innexgo/PCB/README.md

## PCB

This repository contains various designs that may be used in our products.

### Structure

#### In Development

---

In this folder, there are projects in various states of completion, Assume that projects in this folder use designs that are licensed by others. Usage of these designs is *at your own risk*, both functionally and legally.

#### Releases

---

In this folder, the projects are in a stable state, having been tested to work. Again, usage is *at your own risk* and is subject to the license(s) specified in their respective READMEs.
