innexgo/PCB/In Development/ID-12 Board/README.md

# ID-12LA Board for the ESP32 Devkit
---
PCB files for the RFID controller board in KiCad schematic and board layout.

### Features
- Power LED
- 2 Status LEDs
- 3.3v Buzzer on board 
- Allows for jumpering unused ESP32 pins

# Description
---
For usage with the 30-pin ESP32 Devkit and an ID-12 module connected through UART.

The files in contained herein are designed by Henry Chen/probablyanasian for Innexgo LLC. 

We release this design for use under the [CERN Open Hardware Licence Version 2 - Weakly Reciprocal License](/LICENSE_CERN_OHL_W_2-0.txt).
