innexgo/PCB/In Development/MFRC522 Board/README.md

## MFRC522 board for the NodeMCUv2

PCB files for the RFID controller board - in KiCad schematic and board layout.

## Description

For usage with the NodeMCUv2, connects to the MFRC522 through SPI.

#### Features

- ###### MFRC522 over SPI

- ###### Tuned 13.56MHz Antenna (adapted, see [licenses](#licenses))

- ###### Controllable Status light

- ###### 440 Hz buzzer || passive buzzer

## Licenses

The antenna and matching circuitry was designed by Limor Fried/Ladyada and Kevin Townsend for Adafruit Industries.

It has been adapted to be used with the MFRC522 IC from NXP.

Their original design can be found here: [Adafruit NFC/RFID controller breakout board - v1.6 PCB](https://github.com/adafruit/Adafruit-PN532-RFID-NFC-Breakout), under the Creative Commons Attribution-ShareAlike 3.0 Unported license.

Creative Commons Attribution-ShareAlike 3.0 Unported legal text: [Web Link](https://creativecommons.org/licenses/by-sa/3.0/legalcode)  |  [Current Repo Link](/LICENSE_CC_BY_SA_3.txt)

Original README.md text from their repo: [Web Link](https://github.com/adafruit/Adafruit-PN532-RFID-NFC-Breakout/blob/master/README.md)  |  [Current Repo Link, assetless](ref/Adafruit_PN532_Breakout_README.md)

---

Additional work designed by Henry Chen/Probably an Asian for Innexgo LLC.

All additional work by Henry Chen/Probably an Asian is licensed under the Creative Commons Attribution-ShareAlike 4.0 International License. To view a copy of this license, visit [Web Link](http://creativecommons.org/licenses/by-sa/4.0/),  [Current Repo Link](/LICENSE_CC_BY_SA_4.txt), or send a letter to Creative Commons, PO Box 1866, Mountain View, CA 94042, USA.
