innexgo/PCB/In Development/LED Board/README.md

## LED Panel

PCB files for a LED light - in KiCad schematic and board layout.

## Description

#### Features

- ###### ~20mA current controlled

- ###### Current is controllable using trimmer potentiometer

- ###### Designed for 0.5W components

- ###### Designed with a screw terminal in mind

## Licenses

Designed by Henry Chen/Probably an Asian.

Work is licensed under the Creative Commons Attribution-ShareAlike 4.0 International License. To view a copy of this license, visit [Web Link](http://creativecommons.org/licenses/by-sa/4.0/),  [Current Repo Link](/LICENSE_CC_BY_SA_4.txt), or send a letter to Creative Commons, PO Box 1866, Mountain View, CA 94042, USA.
