innexgo/PCB/Releases/LED Timer/README.md

## LED Timer board for the ESP-12 controllers

PCB files for the LED Timer Board - in KiCad schematic and board layout.

## Description

For usage with an ESP-12 Module, connects to 12V LED tape.

#### Features

- ###### Indicator Lights (12V, 3.3V, Status) 3.3v also indicates a healthy 5V supply.

- ###### Controllable status light

- ###### Multifunctional switch

- ###### Reset switch

- ###### External power port

## Licenses

---

Designed by Henry Chen/Probably an Asian for Innexgo LLC.

All work by Henry Chen/Probably an Asian is licensed under the Creative Commons Attribution-ShareAlike 4.0 International License. To view a copy of this license, visit [Web Link](http://creativecommons.org/licenses/by-sa/4.0/),  [Current Repo Link](/LICENSE_CC_BY_SA_4.txt), or send a letter to Creative Commons, PO Box 1866, Mountain View, CA 94042, USA.
