innexgo/PCB/In Development/LED Timer/LED Timer/LED Timer.kicad_pcb

## KiCad design In Development/LED Timer/LED Timer/LED Timer.kicad_pcb (2021-04-25)

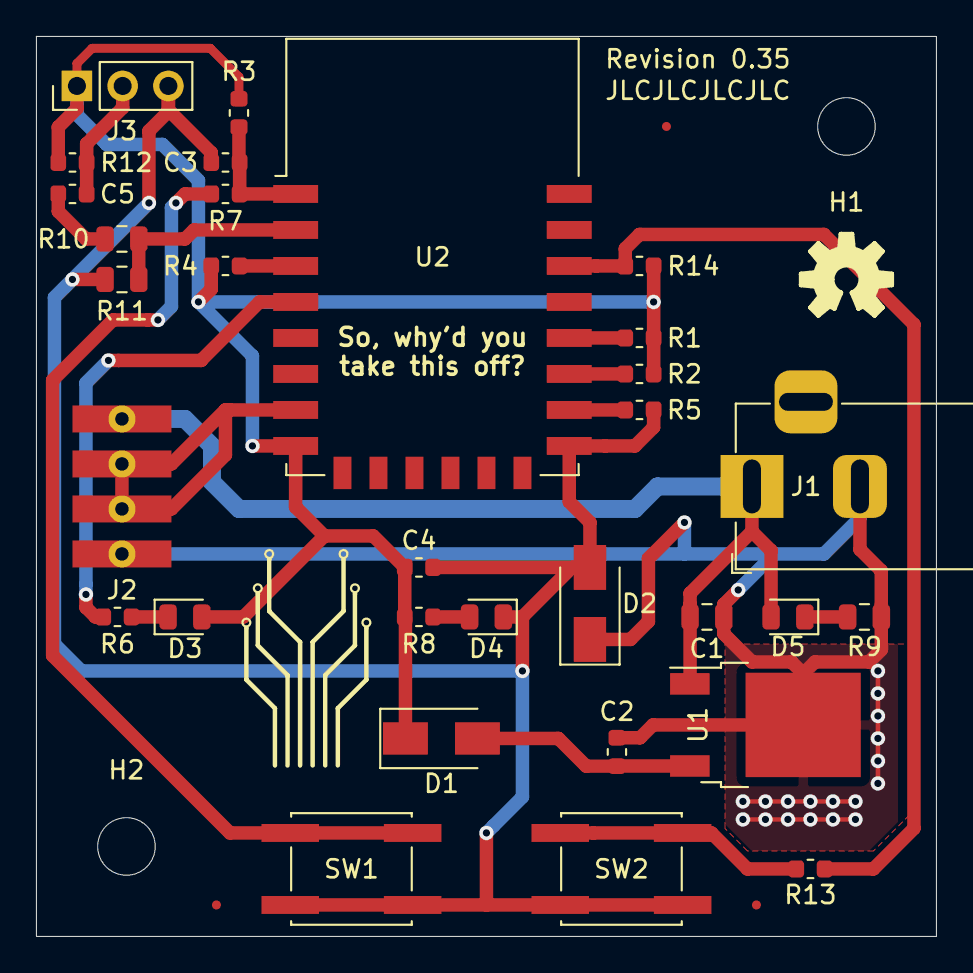
[picture p3: board LED Timer.kicad_pcb from above]

Board: 2 copper layers, 50.0 x 50.0 mm, 38 parts (1 on the bottom side), 21 nets.

Parts:
C1: 0.33uF; C_0805_2012Metric
C2, C3, C4: 0.1uF; C_0603_1608Metric
C5: 1uF DNP; C_0603_1608Metric
D1, D2: Diode; D_SMA
D3, D4: Blue 3.2; LED_0805_2012Metric
D5: Red 2; LED_0805_2012Metric
FID1, FID2, FID3: Fiducial; Fiducial_0.5mm_Mask1mm
H1, H2: MountingHole; MountingHole_3.2mm_M3
J1: Barrel_Jack_Switch; BarrelJack_Horizontal
J2: 4x_1.5mm_5.5mm_bare_copper
J2#2: Conn_01x04_Male; 4x_1.5mm_5.5mm_bare_copper_+THT
J3: Conn_01x03_Female; PinHeader_1x03_P2.54mm_Vertical
LOGO1: Logo_Open_Hardware_Small; OSHWLOGO_TOP_0.2_SC-ver
R1, R2, R3, R4, R5, R14: 10K; R_0603_1608Metric
R6, R8: 22; R_0603_1608Metric
R7, R13: 470; R_0603_1608Metric
R9: 510; R_0805_2012Metric
R10: 220K 1% DNP; R_0805_2012Metric
R11: 100k 1% DNP; R_0805_2012Metric
R12: 2.2K DNP; R_0603_1608Metric
SW1: DNP; SW_SPST_EVQQ2
SW2: SW2; SW_SPST_EVQQ2
U1: LM7805_TO252-2; TO-252-2
U2: ESP-12E

Connections:
+3.3VA: C4.1, D1.1, D3.2, J3.1, R1.1, R2.1, R3.2, R4.1, R8.1, R12.2, R14.1, U2.8
+5V: C2.1, D1.2, U1.3
+12V: C1.2, D5.2, J1.1, J2.4, J2#2.4, U1.1
/0VA: C3.2, C4.2, D2.2, D4.1, J3.3, R5.1, R11.1, SW1.2, SW2.2, U2.15
/ADC: R10.1, R11.2, U2.2
/EN: R4.2, U2.3
/EXT_ADC: C5.1, R10.2
/GPIO0: R1.2, U2.18
/GPIO2: R2.2, U2.17
/GPIO5: R13.1, R14.2, U2.20
/GPIO13: J2.2, J2.3, J2#2.2, J2#2.3, U2.7
/GPIO15: R5.2, U2.16
/GPIO16: R6.2, U2.4
/RST: C3.1, R3.1, R7.1, U2.1
GND: C1.1, C2.2, D2.1, J1.2, J1.3, J2.1, J2#2.1, R9.1, U1.2
unnamed: C5.2, J3.2, R12.1
unnamed: D3.1, R6.1
unnamed: D4.2, R8.2
unnamed: D5.1, R9.2
unnamed: R7.2, SW1.1
unnamed: R13.2, SW2.1
