innexgo/PCB/In Development/LED Board/LED Board/LED Board.kicad_pcb

## KiCad design In Development/LED Board/LED Board/LED Board.kicad_pcb (2021-04-25)

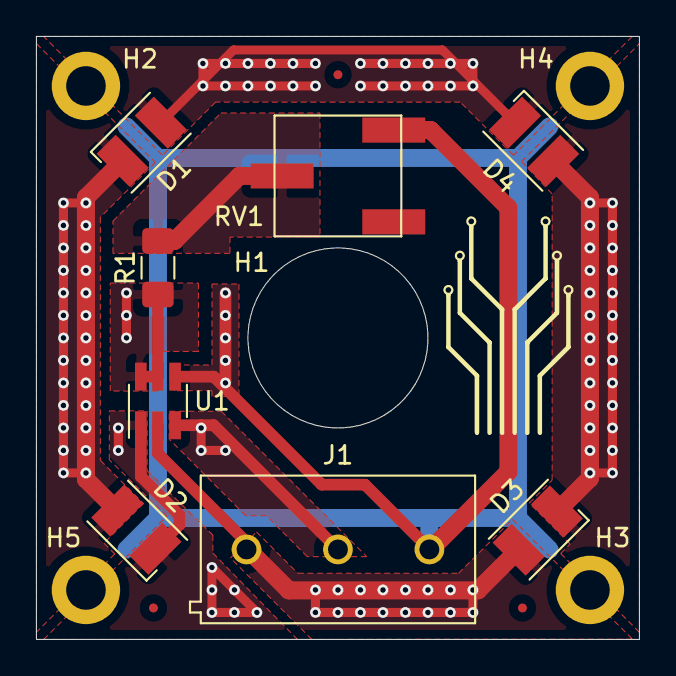
[picture p4: board LED Board.kicad_pcb from above]

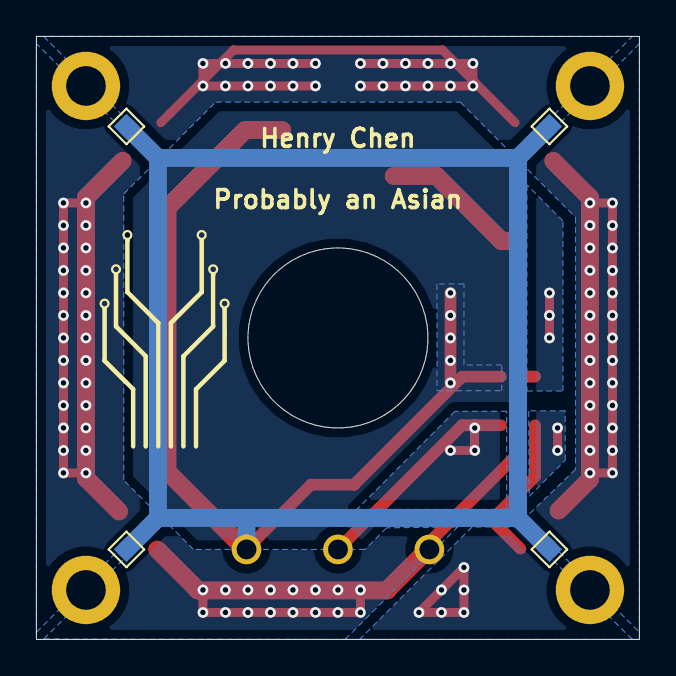
[picture p5: board LED Board.kicad_pcb from below]

Board: 2 copper layers, 33.5 x 33.5 mm, 20 parts (4 on the bottom side), 9 nets.

Parts:
D1, D2, D3, D4: LED_ALT; LED_PLCC-2
FID1, FID2, FID3: Fiducial; Fiducial_0.5mm_Mask1mm
H1: MountingHole; Hole_10mm
H2, H3, H4, H5: MountingHole; MountingHole_2.2mm_M2_DIN965_Pad
J1: Screw_Terminal_01x03; TE-C_3_Pos_Buchanan_Screw_Terminal
R1: 43; R_1206_3216Metric_Pad1.42x1.75mm_HandSolder
RV1: 20; Bourns_3361_Pot
TP1, TP2, TP3, TP4: TestPoint; TestPoint_Pad_1.0x1.0mm
U1: AL5802; SOT-23-6_Handsoldering

Connections:
/EN: J1.2, U1.3
GND: J1.3, RV1.3, TP1.1, TP2.1, TP3.1, TP4.1, U1.4
unnamed: D1.1, D2.2
unnamed: D1.2, D4.1
unnamed: D2.1, U1.1
unnamed: D3.1, D4.2
unnamed: R1.1, U1.5, U1.6
unnamed: R1.2, RV1.2
VCC: D3.2, J1.1, U1.2
