innexgo/PCB/(commit log)

2020-04-29 First commit with MFRC522 board v1.3 in KiCad.
    [PCB Nodev3 v1.3.kicad_pcb, PCB Nodev3 v1.3.sch]
2020-04-29 Ran DRC, buzzer may lean over the edge.
    [PCB Nodev3 v1.3.kicad_pcb]
2020-04-30 Added licenses, and started README
    [PCB Nodev3 v1.3.kicad_pcb]
2020-04-30 moved stuff to allow multiple boards in the same repo
    [PCB Nodev3 v1.3.kicad_pcb, PCB Nodev3 v1.3.sch]
2020-05-03 reworked directories
    [PCB Nodev3 v1.3.kicad_pcb, PCB Nodev3 v1.3.sch, PCB Nodev3 v1.31.kicad_pcb, PCB Nodev3 v1.31.sch]
2020-05-05 redrew, and anotatted some caps and leds
    [PCB Nodev3 v1.31.kicad_pcb, PCB Nodev3 v1.31.sch]
2020-05-07 Added logo.
    [PCB Nodev3 v1.31.kicad_pcb]
2020-05-07 moved a trace
    [PCB Nodev3 v1.31.kicad_pcb]
2020-05-07 Moved Logo, changed some 3dmodels.
    [PCB Nodev3 v1.31.kicad_pcb]
2020-05-09 Made a temp cutoff board, well generic LED
    [Temperature LED.kicad_pcb, Temperature LED.sch]
2020-05-09 better via placement, silkscreen
    [LED Board.kicad_pcb]
2020-05-10 thermals improved, a lot.
    [LED Board.kicad_pcb]
2020-05-10 Mild edits.
    [LED Board.kicad_pcb]
2020-05-10 fixed DRC issues with fill
    [LED Board.kicad_pcb]
2020-05-10 added thermal pads
    [PCB Nodev3 v1.31.kicad_pcb]
2020-05-10 Added readme for LED board, relinked
2020-05-23 MFRC522 silkscreen edit, LED thermal improvement
    [LED Board - 30mm^2.kicad_pcb, LED Board.kicad_pcb, LED Board.sch, PCB Nodev3 v1.31.kicad_pcb]
2020-05-23 renamed files to be more logical
    [MFRC522 PCB Nodev3.kicad_pcb, MFRC522 PCB Nodev3.sch]
2020-05-27 temp for LED timer board
    [LED Timer.kicad_pcb, LED Timer.sch]
2020-05-27 prep for ordering
    [LED Board.kicad_pcb, MFRC522 PCB Nodev3.sch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]
2020-05-27 added a switch to dectect for soft-reset
    [LED Timer.kicad_pcb, LED Timer.sch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]
2020-05-28 added "Innexgo LLC" to the board.
    [LED Timer.kicad_pcb]
2020-05-29 actually the V2, not V3
    [MFRC522 PCB Nodev2.kicad_pcb, MFRC522 PCB Nodev2.sch]
2020-06-09 In production.
    [LED Board.kicad_pcb, LED Board.sch, LED Timer -bkup.kicad_pcb, LED Timer -bkupv2.kicad_pcb, LED Timer -bkupv3.kicad_pcb, LED Timer.kicad_pcb, LED Timer.sch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]
2020-06-25 Release LED_Timer
    [LED Timer.kicad_pcb, LED Timer.sch]
2021-04-25 updates... a lot.
    [LED Board - 30mm^2.kicad_pcb, LED Board.kicad_pcb, LED Board.sch, LED Timer -bkup.kicad_pcb, LED Timer -bkupv2.kicad_pcb, LED Timer -bkupv3.kicad_pcb, LED Timer.kicad_pcb, LED Timer.sch]
2021-04-25 update for ESP32, so not actually Node anymore
    [MFRC522 PCB Nodev2.kicad_pcb, MFRC522 PCB Nodev2.sch]
2021-04-25 upd esp32
    [MFRC522 PCB Nodev2.kicad_pcb]
2021-04-25 rewired signal for less parallel
    [MFRC522 PCB ESP32.kicad_pcb]
2021-04-26 placement updated
    [MFRC522 PCB ESP32.kicad_pcb, MFRC522 PCB ESP32.sch]
2021-04-27 more edits`
    [MFRC522 PCB ESP32.kicad_pcb, MFRC522 PCB ESP32.sch]
2021-05-23 mfrc522 v2 80x80 laid out
    [MFRC522 PCB ESP32.kicad_pcb, MFRC522 PCB ESP32.sch]
2021-05-23 retune length
    [MFRC522 PCB ESP32.kicad_pcb]
2021-05-23 replaced silkscreen locations
    [MFRC522 PCB ESP32.kicad_pcb]
2022-02-07 push v2.01
    [MFRC522 PCB ESP32-B_Cu.gbl, MFRC522 PCB ESP32-B_Mask.gbs, MFRC522 PCB ESP32-B_Paste.gbp, MFRC522 PCB ESP32-B_SilkS.gbo, MFRC522 PCB ESP32-Edge_Cuts.gm1, MFRC522 PCB ESP32-F_Cu.gtl, MFRC522 PCB ESP32-F_Mask.gts, MFRC522 PCB ESP32-F_Paste.gtp]
2022-08-04 update all files
    [MFRC522 PCB ESP32-B_Cu.gbl, MFRC522 PCB ESP32-B_Mask.gbs, MFRC522 PCB ESP32-B_Paste.gbp, MFRC522 PCB ESP32-B_SilkS.gbo, MFRC522 PCB ESP32-Edge_Cuts.gm1, MFRC522 PCB ESP32-F_Cu.gtl, MFRC522 PCB ESP32-F_Mask.gts, MFRC522 PCB ESP32-F_Paste.gtp]
2022-08-15 rm buzzer resistors add lettering to back
    [MFRC522 PCB ESP32-B_Cu.gbl, MFRC522 PCB ESP32-B_Mask.gbs, MFRC522 PCB ESP32-B_Paste.gbp, MFRC522 PCB ESP32-B_SilkS.gbo, MFRC522 PCB ESP32-Edge_Cuts.gm1, MFRC522 PCB ESP32-F_Cu.gtl, MFRC522 PCB ESP32-F_Mask.gts, MFRC522 PCB ESP32-F_Paste.gtp]
2022-08-15 add v2.03 files to release folder
    [MFRC522 PCB ESP32.kicad_pcb, MFRC522 PCB ESP32.sch]
2023-02-19 push what I didn't
    [MFRC522 PCB ESP32-B_Cu.gbl, MFRC522 PCB ESP32-B_Mask.gbs, MFRC522 PCB ESP32-B_Paste.gbp, MFRC522 PCB ESP32-B_SilkS.gbo, MFRC522 PCB ESP32-Edge_Cuts.gm1, MFRC522 PCB ESP32-F_Cu.gtl, MFRC522 PCB ESP32-F_Mask.gts, MFRC522 PCB ESP32-F_Paste.gtp]
2023-06-17 add ID-12 board design, license, update readme
    [ID-12 Board-B_Cu.gbl, ID-12 Board-B_Mask.gbs, ID-12 Board-B_Paste.gbp, ID-12 Board-B_SilkS.gbo, ID-12 Board-Edge_Cuts.gm1, ID-12 Board-F_Cu.gtl, ID-12 Board-F_Mask.gts, ID-12 Board-F_Paste.gtp]
